gutschke/garbagedisposal/easyeda/schematics.pdf

+5V

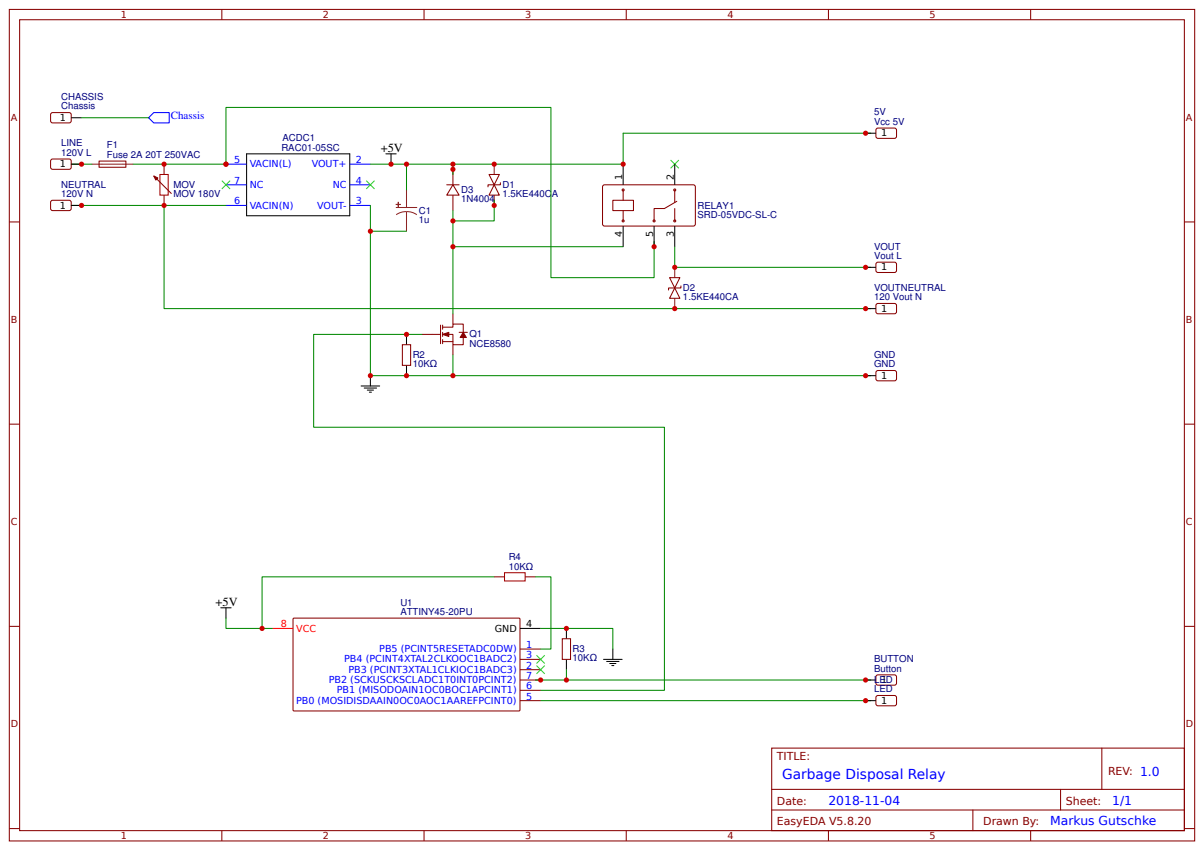
[picture p2: page 1]
