gutschke/garbagedisposal/easyeda/pcb.pdf

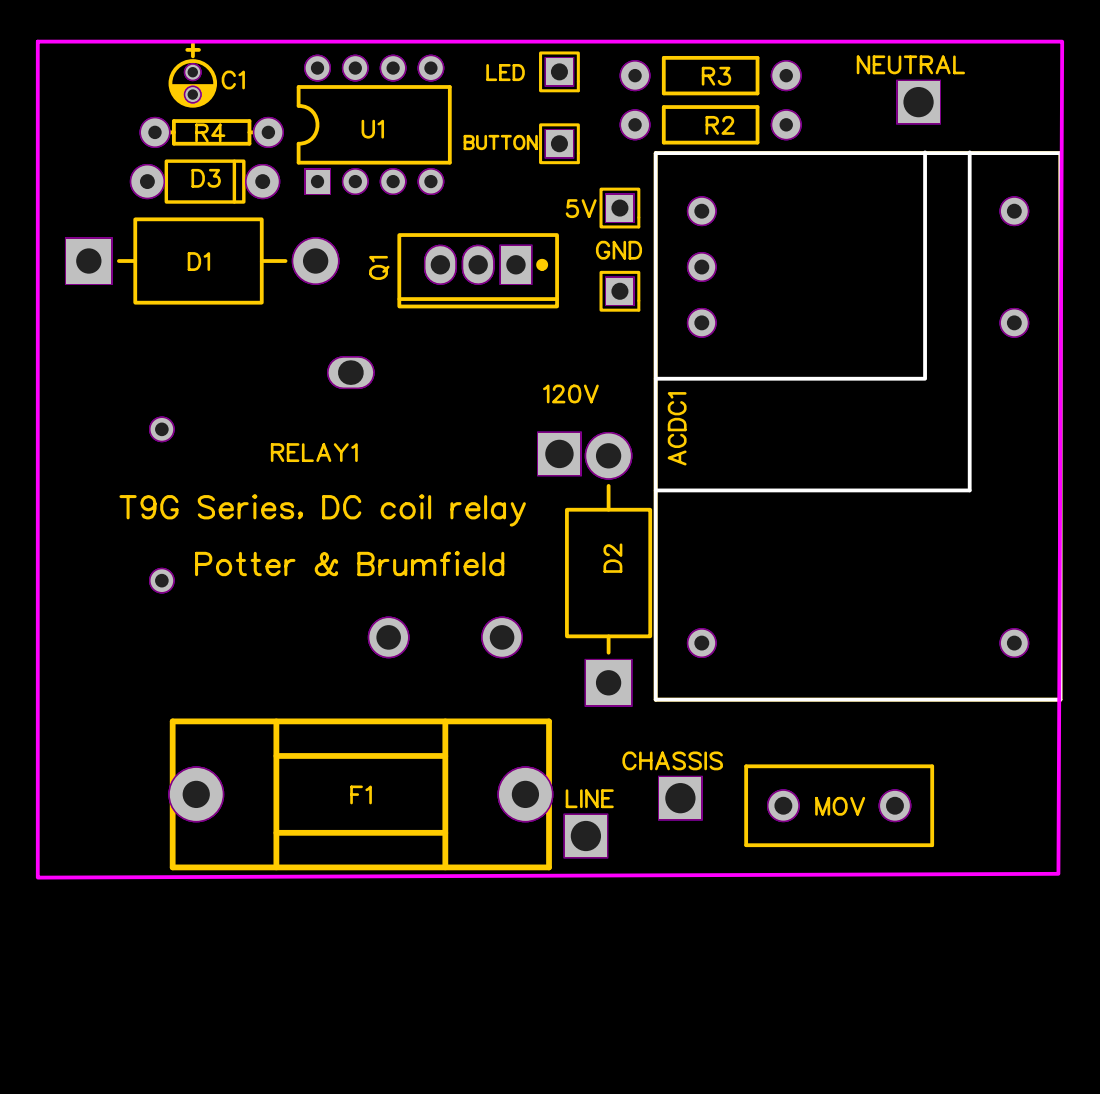
[picture p3: page 1]
