gutschke/garbagedisposal/(list of files, drawings)

Other design files:
easyeda/pcb.json
easyeda/schematics.json
