gutschke/garbagedisposal/(commit log)

2018-11-05 Initial public release
    [pcb.json, schematics.json]
2018-11-07 Change the part number for the fuse holder
2018-11-07 Updated part number for fuse
2018-11-07 Fixed link for ACDC power supply and for IC socket
2018-11-07 This relay is more suitable for switching inductive loads
2018-11-07 Clarified selection of relay
2018-11-11 Replaced relay with smaller version (don't actually need external clips)
2018-11-15 Also enforce cool-off period for turning on the motor.
2018-11-17 Updated PCB. Bigger copper areas. Adjusted hole sizes. Added pull-up resistor for ATTiny. Added capacitor.
    [pcb.json, schematics.json]
2018-11-17 Added pull-up resistor for ATTiny and capacitor.
2018-11-17 Updated link for power supply
2018-11-17 Fixed hole sizes for wires
    [pcb.json]
2018-11-18 Added a ground plane that connects to the chassis and provides extra protection in case of short circuits.
    [pcb.json, schematics.json]
2018-11-18 Added backed a NEUTRAL connection that had gone missing.
    [pcb.json]
2018-11-18 Detailed BOM
2018-11-18 Discuss total material costs
2018-11-18 Details on how the button is wired up
2019-09-22 Find nylon spacers that are in stock
